eccentricfae/Led-Matrix/docs/pics-and-videos/main_menu.jpg

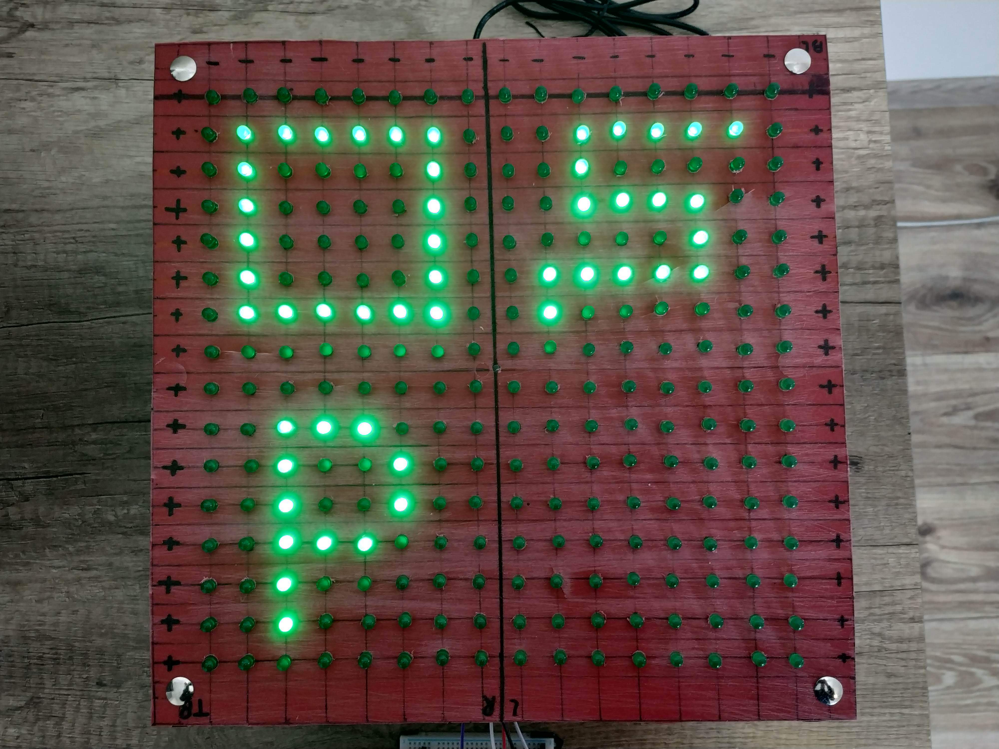
docs/pics-and-videos/main_menu.jpg
