eccentricfae/Led-Matrix/docs/pics-and-videos/transistor_boards.jpg

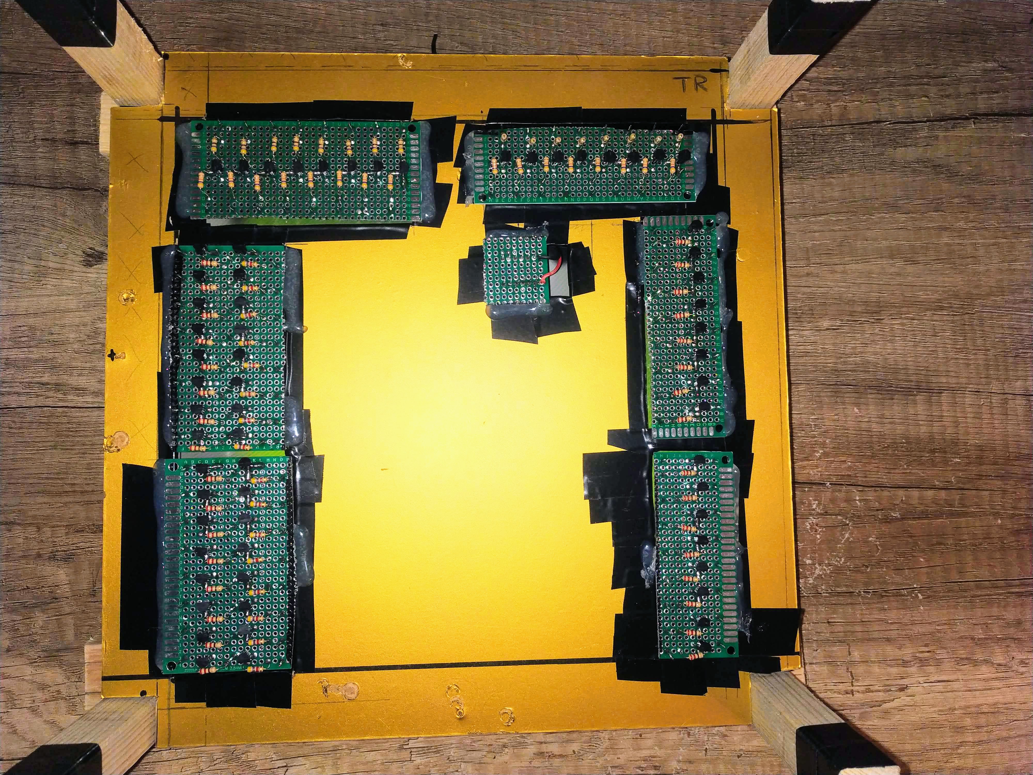
docs/pics-and-videos/transistor_boards.jpg
