eccentricfae/Led-Matrix/docs/schematic-srcs/input_device.pdf

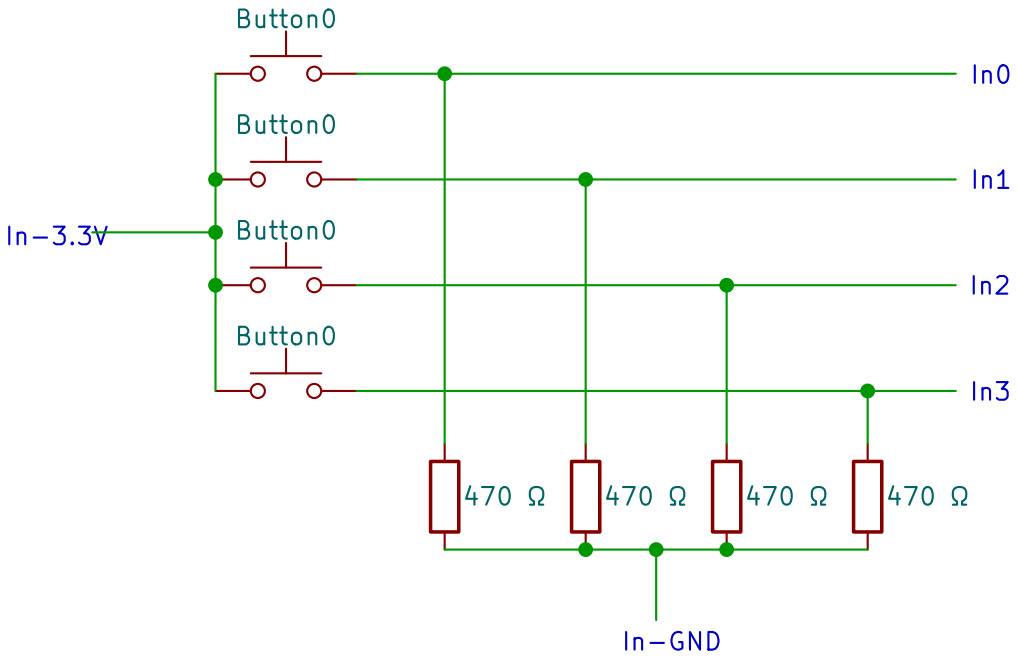
[picture p6: page 1]

File: input_device.kicad_sch Sheet: /
13.09.2022 "led-matrix" project schematic, page 4/4
