eccentricfae/Led-Matrix/docs/aux/explanation_NPN_PNP.pdf

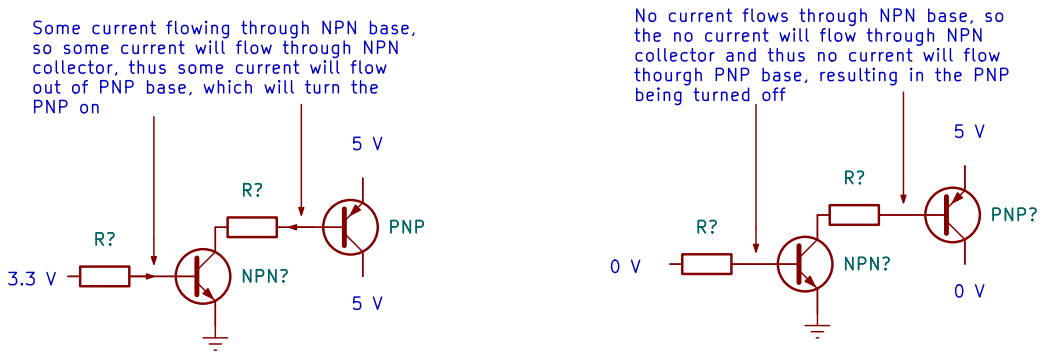
[picture p7: page 1]

Some current flowing through NPN base,
so some current will flow through NPN collector, thus some current will flow

the no current will flow through NPN
collector and thus no current will flow
thourgh PNP base, resulting in the PNP

out of PNP base, which will turn the PNP on
